tetuante/solarNodeCasting/README.md

# solarNodeCasting
Project to build a sensor node to be used for short-term solar casting
