tetuante/solarNodeCasting/PCB/presupuestos/Nodo solar/presupuesto.xlsx

Sheet: Total
Ref (PCB) | Qty | Type | Hand Soldering | Value | Footprint | Notes | Link | Price 1u (€) | Price 5u (€) | Price 10u (€) | Total Qty (5 nodes) | Total Qty (10 nodes) |  | Total 5n (€) | Total 10n (€)
C4 | 1 | THT | Y | 4700uF/10V | Capacitors_THT:CP_Radial_D13.0mm_P5.00mm | Electrolitico, paso 5 mm | https://www.digikey.es/product-detail/es/panasonic-electronic-components/EEU-FS1A472/P122372-ND/7381238 | 1.01000 | 1.01000 | 0.79800 | 5 | 10 |  | 5.05 | 7.98
C1 C2 C11 C12 | 4 | SMD | Y | 10uF/16V X5R | Capacitors_SMD:C_0805_HandSoldering |  | https://www.mouser.es/ProductDetail/KEMET/C0805C106K4PACTU/ | 0.24700 | 0.24700 | 0.11500 | 20 | 40 |  | 2.30 | 4.60
C3 | 1 | SMD | Y | 0.1uF | Capacitors_SMD:C_0805_HandSoldering |  | https://www.mouser.es/ProductDetail/KEMET/C0805C104K4RAC/ | 0.08500 | 0.08500 | 0.03700 | 5 | 10 |  | 0.43 | 0.37
C6 | 1 | SMD | Y | 10pF | Capacitors_SMD:C_0805_HandSoldering |  | https://www.mouser.es/ProductDetail/KEMET/C0805C100M4GACTU/ | 0.08500 | 0.08500 | 0.05400 | 5 | 10 |  | 0.43 | 0.54
C7 | 1 | SMD | Y | 1uF/10V X5R | Capacitors_SMD:C_0805_HandSoldering |  | https://www.mouser.es/ProductDetail/KEMET/C0805C105K8RACTM/ | 0.11100 | 0.11100 | 0.04600 | 5 | 10 |  | 0.56 | 0.46
C8 C9 C10 | 3 | SMD | Y | 22uF/10V X5R | Capacitors_SMD:C_0805_HandSoldering |  | https://www.mouser.es/ProductDetail/KEMET/C0805C226M8PACTU/ | 0.34900 | 0.34900 | 0.18400 | 15 | 30 |  | 2.76 | 5.52
C5 | 1 | SMD | Y | 10uF/10V | Capacitors_SMD:C_0805_HandSoldering |  | https://www.mouser.es/ProductDetail/KEMET/C0805C106K8PACTU/?qs=sGAEpiMZZMs0AnBnWHyRQI9zuYIiQALCxT7NLyqb6iU%3d | 0.20400 | 0.20400 | 0.13400 | 5 | 10 |  | 1.02 | 1.34
D1 | 1 | SMD | N | MBR120VLSFT1G | SolarNodeFootprints:D_SOD-123FL | Diodo rectificador | https://www.mouser.es/ProductDetail/ON-Semiconductor/MBR120VLSFT3G/ | 0.31500 | 0.31500 | 0.23800 | 5 | 10 |  | 1.57 | 2.38
D2 | 1 | SMD | Y | ORANGE | LEDs:LED_0805_HandSoldering | LED naranja Vf = 1.922 V If = 4 mA | https://www.mouser.es/ProductDetail/Kingbright/APTD2012LSYCK/ | 0.28100 | 0.28100 | 0.17400 | 5 | 10 |  | 1.41 | 1.74
D3 D5 | 2 | SMD | Y | GREEN | LEDs:LED_0805_HandSoldering | LED verde Vf = 1.946 If = 4 mA | https://www.mouser.es/ProductDetail/Kingbright/APTD2012LCGCK/ | 0.30600 | 0.30600 | 0.19000 | 10 | 20 |  | 1.90 | 3.80
D4 | 1 | SMD | Y | RED | LEDs:LED_0805_HandSoldering | LED rojo Vf = 1.858 If = 4 mA | https://www.mouser.es/ProductDetail/Kingbright/APTD2012LSURCK/ | 0.28100 | 0.28100 | 0.17400 | 5 | 10 |  | 1.41 | 1.74
J2 | 1 | THT | Y | microUSB CHRG | Connectors:USB_Micro-B | microUSB tipo B | https://www.mouser.es/ProductDetail/Hirose-Connector/ZX62D-B-5PA830/ | 0.59500 | 0.59500 | 0.47600 | 5 | 10 |  | 2.97 | 4.76
J1 | 1 | THT | Y | DCIN | Connectors:BARREL_JACK | 5.5 - 2.1 mm DC jack M | https://www.tme.eu/es/details/fc68148/conectores-dc/cliff/dc-10a-fc68148/ | 0.52000 | 0.52000 | 0.52000 | 5 | 10 |  | 2.60 | 5.20
J1 | 1 | EXT |  | DCIN | Connectors:BARREL_JACK | 5.5 - 2.1 mm DC jack F | https://www.tme.eu/es/details/pc-2.1_5.5-14/conectores-dc/ | 0.25400 | 0.25400 | 0.25400 | 5 | 10 |  | 1.27 | 2.54
J7 SC1 | 2 | SMD | N | BATT Solar_Cell | Connectors_JST:JST_PH_S2B-PH-SM4-TB_02x2.00mm_Angled | Conectores JST PH macho 2 pines | https://www.tme.eu/es/details/s2b-ph-sm4-tb/conectores-de-senal-raster-200mm/jst/ | 0.03380 | 0.03380 | 0.03380 | 10 | 20 |  | 0.34 | 0.68
 | 2 | EXT |  |  |  | Conectores JST PH hembra 2 pines | https://www.tme.eu/es/details/02kr-6h-p/conectores-de-senal-raster-200mm/jst/ | 0.30000 | 0.30000 | 0.30000 | 10 | 20 |  | 3.00 | 6.00
J3 J4 J5 J6 J8 | 1 | THT | Y |  | Pin headers. Male, 1x25 |  | https://www.mouser.es/ProductDetail/Molex/22-28-4250/ | 0.72300 | 0.72300 | 0.57000 | 5 | 10 |  | 3.61 | 5.70
 | 2 | EXT |  | DHT22 & DS18B20 | Pines hembra 3x1 | Conectores hembra | https://www.mouser.es/ProductDetail/Molex/14-60-0036/ | 0.67200 | 0.67200 | 0.58100 | 10 | 20 |  | 5.81 | 11.62
L1 | 1 | SMD | Y | NRS5030T1R0NMGJ | Inductors_SMD:L_Taiyo-Yuden_NR-50xx_HandSoldering | Inductor buck/boost | https://www.mouser.es/ProductDetail/Taiyo-Yuden/NRS5030T1R0NMGJ/ | 0.32300 | 0.32300 | 0.25200 | 5 | 10 |  | 1.61 | 2.52
Q1 | 1 | SMD | N | BSS138 | TO_SOT_Packages_SMD:SOT-23 | Transistor | https://www.mouser.es/ProductDetail/ON-Semiconductor-Fairchild/BSS138L/ | 0.18700 | 0.18700 | 0.12300 | 5 | 10 |  | 0.94 | 1.23
R15 | 1 | SMD | Y | 1153 | Resistors_SMD:R_0805_HandSoldering | 115k 1% | https://www.mouser.es/ProductDetail/Yageo/RC0805FR-07115KL/?qs=sGAEpiMZZMtlubZbdhIBIHuAoAkAo22N7v2fnh1eVEQ%3d | 0.08500 | 0.08500 | 0.01400 | 5 | 10 |  | 0.43 | 0.14
R16 | 1 | SMD | Y | 5602 | Resistors_SMD:R_0805_HandSoldering | 56k 1% | https://www.mouser.es/ProductDetail/Yageo/RC0805FR-0756KL/ | 0.08500 | 0.08500 | 0.01400 | 5 | 10 |  | 0.43 | 0.14
R3 R6 R9 R14 R13 | 5 | SMD | Y | 1001 | Resistors_SMD:R_0805_HandSoldering | 1k 1% | https://www.mouser.es/ProductDetail/Yageo/RC0805FR-071KL/?qs=sGAEpiMZZMtlubZbdhIBINUJ4p5cMnF1Rv8sEVwr4ss%3d | 0.08500 | 0.08500 | 0.01400 | 25 | 50 |  | 0.35 | 0.70
R1 | 1 | SMD | Y | 0 | Resistors_SMD:R_0805_HandSoldering | 0R 5% | https://www.mouser.es/ProductDetail/Yageo/RC0805JR-070RS/ | 0.11900 | 0.11900 | 0.01400 | 5 | 10 |  | 0.59 | 0.14
R10 | 1 | SMD | Y | 2703 | Resistors_SMD:R_0805_HandSoldering | 270k 1% | https://www.mouser.es/ProductDetail/Yageo/RC0805FR-07270KL/ | 0.08500 | 0.08500 | 0.01400 | 5 | 10 |  | 0.43 | 0.14
R11 R12 | 2 | SMD | Y | 104 | Resistors_SMD:R_0805_HandSoldering | 100k 5% | https://www.mouser.es/ProductDetail/Yageo/RC0805JR-07100KL/ | 0.08500 | 0.08500 | 0.01100 | 10 | 20 |  | 0.11 | 0.22
R7 R2 R5 | 3 | SMD | Y | 1053 | Resistors_SMD:R_0805_HandSoldering | 105k 1% | https://www.mouser.es/ProductDetail/Yageo/RC0805FR-07105KL/ | 0.08500 | 0.08500 | 0.01400 | 15 | 30 |  | 0.21 | 0.42
R4 R8 | 2 | SMD | Y | 105 | Resistors_SMD:R_0805_HandSoldering | 1M 5% | https://www.mouser.es/ProductDetail/Yageo/RC0805JR-071ML/ | 0.08500 | 0.08500 | 0.01100 | 10 | 20 |  | 0.11 | 0.22
RT1 | 1 | SMD | Y | 1503 | Resistors_SMD:R_0805_HandSoldering | 150k 1% | https://www.mouser.es/ProductDetail/Yageo/RC0805FR-07150KL/?qs=sGAEpiMZZMtlubZbdhIBIBEZimkhVqQ4txl6Q1oOo2U%3d | 0.08500 | 0.08500 | 0.01400 | 5 | 10 |  | 0.43 | 0.14
PROG | 1 | SMD | Y | 2001 | SolarNodeFootprints:R_0805_SMD_THT_HandSoldering | 2k 1% | https://www.mouser.es/ProductDetail/Yageo/RC0805FR-072KL/?qs=sGAEpiMZZMtlubZbdhIBIJv49G1poxg9G2UwItFTLLs%3d | 0.08500 | 0.08500 | 0.01400 | 5 | 10 |  | 0.43 | 0.14
THERM | 1 | EXT |  | 3950 NTC | SolarNodeFootprints:R_0805_SMD_THT_HandSoldering | 10k NTC B25/50 = 3950 +- 1% | https://www.mouser.es/ProductDetail/Murata/NXFT15XV103FA2B150/?qs=MY6wChARw2z2TBhtd5BylA%3d%3d | 0.85000 | 0.85000 | 0.56400 | 5 | 10 |  | 4.25 | 5.64
U3 | 2 | THT | Y | LoPy socket | SolarNodeFootprints:LoPy | 14x2 pines hembra largos | https://www.digikey.es/product-detail/es/samtec-inc/SSQ-114-03-T-S/SAM1206-14-ND/1111944 | 1.78000 | 1.78000 | 1.59300 | 10 | 20 |  | 15.93 | 31.86
U3 | 2 | THT | Y | LoPy socket | SolarNodeFootprints:LoPy | 14x2 pines hembra | https://www.digikey.es/product-detail/es/samtec-inc/SSQ-114-01-T-S/SAM1184-14-ND/1110803 | 1.63000 | 1.63000 | 1.45400 | 10 | 20 |  | 14.54 | 29.08
U4 | 1 | SMD | N | LMR982 | Housings_SSOP:MSOP-10_3x3mm_Pitch0.5mm | OpAmp LMR982FVM | https://www.mouser.es/ProductDetail/ROHM-Semiconductor/LMR982FVM-TR/ | 0.67200 | 0.67200 | 0.55700 | 5 | 10 |  | 3.36 | 5.57
U2 | 1 | SMD | N | MCP73871 | SolarNodeFootprints:QFN-20-1EP_4x4mm_Pitch0.5mm | Battery charger | https://www.mouser.es/ProductDetail/Microchip-Technology/MCP73871-2CCI-ML/ | 1.65000 | 1.65000 | 1.52000 | 5 | 10 |  | 8.25 | 15.20
U1 | 1 | SMD | N | TPS63060 | SolarNodeFootprints:S-PWSON-N10 | Power switch | https://www.mouser.es/ProductDetail/Texas-Instruments/TPS63060DSCR/ | 2.03000 | 2.03000 | 1.83000 | 5 | 10 |  | 10.15 | 18.30
 | 1 | EXT |  | LoPy |  | Microcontroller | https://www.mouser.es/ProductDetail/Pycom/LoPy/ | 25.710 | 25.710 | 25.710 | 5 | 10 |  | 128.55 | 257.10
 | 1 | EXT |  | Expansion board |  | Pycom Expansion board | https://www.mouser.es/ProductDetail/Pycom/Expansion-Board/ | 14.720 | 14.720 | 14.720 | 5 | 10 |  | 73.60 | 147.20
 | 1 | EXT |  | Antena LoRa |  | 868 MHz | https://www.mouser.es/ProductDetail/Pycom/LoRa-Sigfox-Antenna-Kit/ | 8.280 | 8.280 | 8.280 | 5 | 10 |  | 41.40 | 82.80
 | 1 | EXT |  | DHT22 |  | T&RH sensor | https://www.mouser.es/ProductDetail/Adafruit/393/?qs=sGAEpiMZZMsMyYRRhGMFNjQer5SXmdKhqdCeGzcwTcI%3d | 12.75000 | 12.75000 | 12.75000 | 5 | 10 |  | 63.75 | 127.50
 | 1 | EXT |  | DS18B20 |  | T sensor | https://www.mouser.es/ProductDetail/Maxim-Integrated/DS18B20+/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 | 2.36000 | 2.36000 | 2.33000 | 5 | 10 |  | 11.80 | 23.30
 | 1 | EXT |  |  |  | Batería LiPo 800 mAh | https://www.tme.eu/es/details/accu-lp503448_cl/baterias/cellevia-batteries/l503448/ | 5.83000 | 5.25000 | 5.25000 | 5 | 10 |  | 26.25 | 52.50
 | 1 | EXT |  |  |  | Panel solar medida | https://www.digikey.es/product-detail/es/ixys/KXOB22-12X1F/KXOB22-12X1F-ND/4840079 | 1.82000 | 1.82000 | 1.64400 | 5 | 10 |  | 9.10 | 16.44
 | 1 | EXT |  |  |  | Panel solar alimentación 6V | https://www.mouser.es/ProductDetail/Adafruit/200/ | 25.64000 | 25.64000 | 25.64000 | 5 | 10 |  | 128.20 | 256.40
Total: | 41 | SMD |  |  |  |  |  |  |  |  |  |  | Total (€): | 583.61 | 1142.01
Total: | 8 | THT
Total: | 14 | EXT |  |  |  |  |  |  |  |  |  |  | Envío TME (€): | 7.90
 |  |  |  |  |  |  |  |  |  |  |  |  | Digikey (€): | 44.62 | 85.36
 |  |  |  |  |  |  |  |  |  |  |  |  | Mouser (€): | 505.53 | 989.73
 |  |  |  |  |  |  |  |  |  |  |  |  | TME (€): | 33.46 | 66.92
 |  |  |  |  |  |  |  |  |  |  |  |  | Digikey THT (€): | 35.52 | 68.92
 |  |  |  |  |  |  |  |  |  |  |  |  | Mouser THT (€): | 6.59 | 10.46
 |  |  |  |  |  |  |  |  |  |  |  |  | TME THT (€): | 2.60 | 5.20
 |  |  |  |  |  |  |  |  |  |  |  |  | Digikey SMD (€): | 0.00 | 0.00
 |  |  |  |  |  |  |  |  |  |  |  |  | Mouser SMD (€): | 41.58 | 67.71
 |  |  |  |  |  |  |  |  |  |  |  |  | TME SMD (€): | 0.34 | 0.68
 |  |  |  |  |  |  |  |  |  |  |  |  | Digikey EXT (€): | 9.10 | 16.44
 |  |  |  |  |  |  |  |  |  |  |  |  | Mouser EXT (€): | 457.36 | 911.56
 |  |  |  |  |  |  |  |  |  |  |  |  | TME EXT (€): | 30.52 | 61.04

Sheet: Digikey
Comprado | Ref (PCB) | Qty | Type | Hand Soldering | Value | Footprint | Notes | Link | Price 1u (€) | Price 5u (€) | Price 10u (€) | Total Qty (5 nodes) | Total Qty (10 nodes) | Total 5n (€) | Total 10n (€)
SI | C4 | 1 | THT | Y | 4700uF/10V | Capacitors_THT:CP_Radial_D13.0mm_P5.00mm | Electrolitico, paso 5 mm | https://www.digikey.es/product-detail/es/panasonic-electronic-components/EEU-FS1A472/P122372-ND/7381238 | 1.01000 | 1.01000 | 0.79800 | 5 | 10 | 5.05 | 7.98
SI | U3 | 2 | THT | Y | LoPy socket | SolarNodeFootprints:LoPy | 14x2 pines hembra largos | https://www.digikey.es/product-detail/es/samtec-inc/SSQ-114-03-T-S/SAM1206-14-ND/1111944 | 1.78000 | 1.78000 | 1.59300 | 10 | 20 | 15.93 | 31.86
SI | U3 | 2 | THT | Y | LoPy socket | SolarNodeFootprints:LoPy | 14x2 pines hembra | https://www.digikey.es/product-detail/es/samtec-inc/SSQ-114-01-T-S/SAM1184-14-ND/1110803 | 1.63000 | 1.63000 | 1.45400 | 10 | 20 | 14.54 | 29.08
SI | SC1 | 1 | EXT |  |  |  | Panel solar medida | https://www.digikey.es/product-detail/es/ixys/SLMD121H04L/SLMD121H04L-ND/3463124 | 5.19000 | 5.19000 | 4.66700 | 5 | 10 | 25.95 | 46.67
AGOTADO | SC1 | 1 | EXT |  |  |  | Panel solar medida | https://www.digikey.es/product-detail/es/ixys/KXOB22-12X1F/KXOB22-12X1F-ND/4840079 | 1.82000 | 1.82000 | 1.64400 | 5 | 10 | 9.10 | 16.44

Sheet: Mouser
Comprado | Ref (PCB) | Qty | Type | Hand Soldering | Value | Footprint | Notes | Link | Price 1u (€) | Price 5u (€) | Price 10u (€) | Total Qty (5 nodes) | Total Qty (10 nodes) | Total 5n (€) | Total 10n (€)
SI | J2 | 1 | THT | Y | microUSB CHRG | Connectors:USB_Micro-B | microUSB tipo B | https://www.mouser.es/ProductDetail/Hirose-Connector/ZX62D-B-5PA830/ | 0.59500 | 0.59500 | 0.47600 | 5 | 10 | 2.97 | 4.76
SI | J3 J4 J5 J6 J8 | 1 | THT | Y |  | Pin headers. Male, 1x25 |  | https://www.mouser.es/ProductDetail/Molex/22-28-4250/ | 0.72300 | 0.72300 | 0.57000 | 5 | 10 | 3.61 | 5.70
SI | J5 J6 | 2 | EXT |  | DHT22 & DS18B20 | Pines hembra 3x1 | Conectores hembra | https://www.mouser.es/ProductDetail/Molex/14-60-0036/ | 0.67200 | 0.67200 | 0.58100 | 10 | 20 | 5.81 | 11.62
SI | THERM | 1 | EXT |  | 3950 NTC | SolarNodeFootprints:R_0805_SMD_THT_HandSoldering | 10k NTC B25/50 = 3950 +- 1% | https://www.mouser.es/ProductDetail/Murata/NXFT15XV103FA2B150/?qs=MY6wChARw2z2TBhtd5BylA%3d%3d | 0.85000 | 0.85000 | 0.56400 | 5 | 10 | 4.25 | 5.64
SI | U3 | 1 | EXT |  | LoPy |  | Microcontroller | https://www.mouser.es/ProductDetail/Pycom/LoPy/ | 25.710 | 25.710 | 25.710 | 5 | 10 | 128.55 | 257.10
SI |  | 1 | EXT |  | Expansion board |  | Pycom Expansion board | https://www.mouser.es/ProductDetail/Pycom/Expansion-Board/ | 14.720 | 14.720 | 14.720 | 5 | 10 | 73.60 | 147.20
SI |  | 1 | EXT |  | Antena LoRa |  | 868 MHz | https://www.mouser.es/ProductDetail/Pycom/LoRa-Sigfox-Antenna-Kit/ | 8.280 | 8.280 | 8.280 | 5 | 10 | 41.40 | 82.80
SI | J6 | 1 | EXT |  | DHT22 |  | T&RH sensor | https://www.mouser.es/ProductDetail/Adafruit/393/?qs=sGAEpiMZZMsMyYRRhGMFNjQer5SXmdKhqdCeGzcwTcI%3d | 12.75000 | 12.75000 | 12.75000 | 5 | 10 | 63.75 | 127.50
SI | J5 | 1 | EXT |  | DS18B20 |  | T sensor | https://www.mouser.es/ProductDetail/Maxim-Integrated/DS18B20+/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 | 2.36000 | 2.36000 | 2.33000 | 5 | 10 | 11.80 | 23.30
SI | J1 | 1 | EXT |  |  |  | Panel solar alimentación 6V | https://www.mouser.es/ProductDetail/Adafruit/200/ | 25.64000 | 25.64000 | 25.64000 | 5 | 10 | 128.20 | 256.40

Sheet: TME
Comprado | Ref (PCB) | Qty | Type | Hand Soldering | Value | Footprint | Notes | Link | Price 1u (€) | Price 5u (€) | Price 10u (€) | Total Qty (5 nodes) | Total Qty (10 nodes) | Total 5n (€) | Total 10n (€)
NO | J1 | 1 | THT | Y | DCIN | Connectors:BARREL_JACK | 5.5 - 2.1 mm DC jack M | https://www.tme.eu/es/details/fc68148/conectores-dc/cliff/dc-10a-fc68148/ | 0.52000 | 0.52000 | 0.52000 | 5 | 10 | 2.60 | 5.20
NO | J1 | 1 | EXT |  | DCIN | Connectors:BARREL_JACK | 5.5 - 2.1 mm DC jack F | https://www.tme.eu/es/details/pc-2.1_5.5-14/conectores-dc/ | 0.25400 | 0.25400 | 0.25400 | 5 | 10 | 1.27 | 2.54
NO | J7 SC1 | 2 | EXT |  |  |  | Conectores JST PH hembra 2 pines | https://www.tme.eu/es/details/02kr-6h-p/conectores-de-senal-raster-200mm/jst/ | 0.30000 | 0.30000 | 0.30000 | 10 | 20 | 3.00 | 6.00
NO | J7 | 1 | EXT |  |  |  | Batería LiPo 800 mAh | https://www.tme.eu/es/details/accu-lp503448_cl/baterias/cellevia-batteries/l503448/ | 5.83000 | 5.25000 | 5.25000 | 5 | 10 | 26.25 | 52.50
