tetuante/solarNodeCasting/PCB/presupuestos/Piranometros/presupuesto.xlsx

Comprado | Ref (PCB) | Qty/board | Type | Value | Notes | Link | Price 1u (€) | Price 5u (€) | Price 10u (€) | Price/board (€) | Price/5boards (€) | Price/10boards (€) | Total/board (€) | Total/5boards (€) | Total/10boards (€)
NO |  | 1 | THT | YR1B100RCC | 100R 0.1% | https://www.mouser.es/ProductDetail/TE-Connectivity/YR1B100RCC/ | 0.32700 | 0.32700 | 0.32700 | 0.32700 | 1.63500 | 3.27000 | 7.004 | 35.02 | 62.74
NO | U2 | 1 | SMD | AD8237ARMZ-R7 | In-Amp | https://www.mouser.es/productdetail/analog-devices/ad8237armz-r7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 | 2.17000 | 2.17000 | 1.94000 | 2.17000 | 10.85000 | 19.40000
NO | U1 | 1 | SMD | AD8538AUJZ-REEL7 | Op-Amp | https://www.mouser.es/ProductDetail/Analog-Devices-Inc/AD8538AUJZ-REEL7/ | 1.19000 | 1.19000 | 1.07000 | 1.19000 | 5.95000 | 10.70000
NO | U3 | 1 | SMD | NTGD1100LT1G | Power MOSFET | https://www.mouser.es/ProductDetail/ON-Semiconductor/NTGD1100LT1G/ | 0.50200 | 0.50200 | 0.41500 | 0.50200 | 2.51000 | 4.15000
NO | R3 | 1 | SMD | PCF0805R-1K0BI | 1K 0.1% | https://www.mouser.es/ProductDetail/TT-Electronics/PCF0805R-1K0BI/ | 0.15300 | 0.15300 | 0.15300 | 0.15300 | 0.76500 | 1.53000
NO | R5 | 1 | SMD | PCF0805R-200KBI | 200K 0.1% | https://www.mouser.es/ProductDetail/TT-Electronics/PCF0805R-200KBI/ | 0.15300 | 0.15300 | 0.15300 | 0.15300 | 0.76500 | 1.53000
NO | SW2 SW3 | 2 | THT | 0S103011MS8QP1 | SP3T switch | https://www.mouser.es/ProductDetail/CK-Components/0S103011MS8QP1/ | 0.43400 | 0.43400 | 0.43400 | 0.86800 | 4.34000 | 8.68000
NO | SW1 | 1 | THT | 0S102011MS2QN1 | SPDT switch | https://www.mouser.es/ProductDetail/CK-Components/0S102011MS2QN1/ | 0.33200 | 0.33200 | 0.33200 | 0.33200 | 1.66000 | 3.32000
NO | C1 | 1 | SMD | C0805C104K4RAC | 0.1uF 16V 10% | https://www.mouser.es/ProductDetail/KEMET/C0805C104K4RAC/ | 0.08500 | 0.08500 | 0.03700 | 0.08500 | 0.42500 | 0.37000
NO | J2 | 1 | THT | EM366503 | Terminal block | https://www.mouser.es/ProductDetail/Eaton/EM366503/ | 0.32300 | 0.32300 | 0.31900 | 0.32300 | 1.61500 | 3.19000
NO | J1 | 1 | THT | M20-7820546 | Female pins | https://www.mouser.es/productdetail/harwin/m20-7820546 | 0.73100 | 0.73100 | 0.58800 | 0.73100 | 3.65500 | 5.88000
NO | R4 R6 | 2 | SMD | CRCW0805100KJNEA | 100K 5% | https://www.mouser.es/productdetail/vishay/crcw0805100kjnea?qs=sGAEpiMZZMvdGkrng054txEw7b1YnvGuWk57hmbzOr0%3D | 0.08500 | 0.08500 | 0.03600 | 0.17000 | 0.85000 | 0.72000
