tetuante/solarNodeCasting/soporte/celula22x7/Soporte18x18x12.3mf

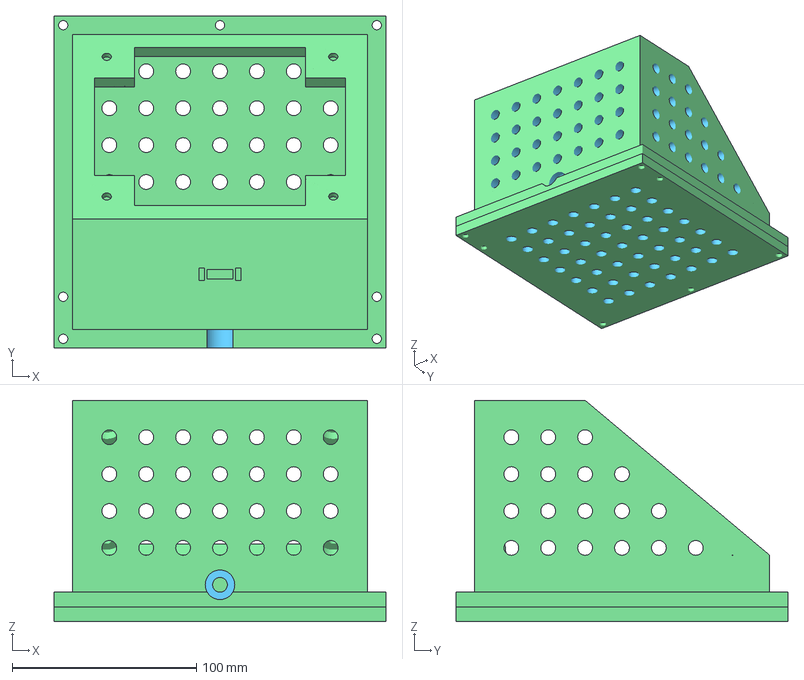
[picture p1: CAD file, 2018-02-06]
soporte/celula22x7/Soporte18x18x12.3mf
180.0 x 180.0 x 120.0 mm
