tetuante/solarNodeCasting/soporte/partes.3mf

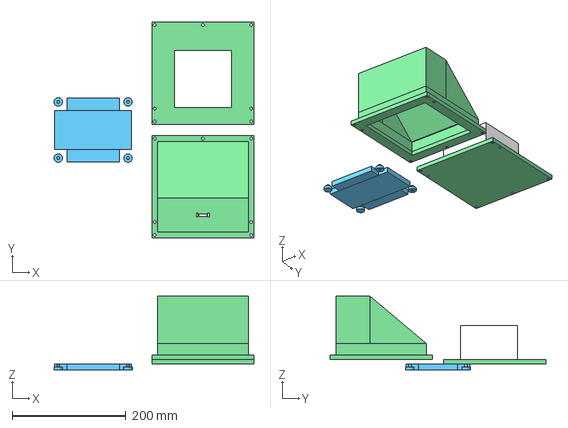
[picture p2: CAD file, 2018-02-06]
soporte/partes.3mf
352.2 x 380.0 x 130.0 mm
