tetuante/solarNodeCasting/soporte/celula22x7/Soporte18x18x10.3mf

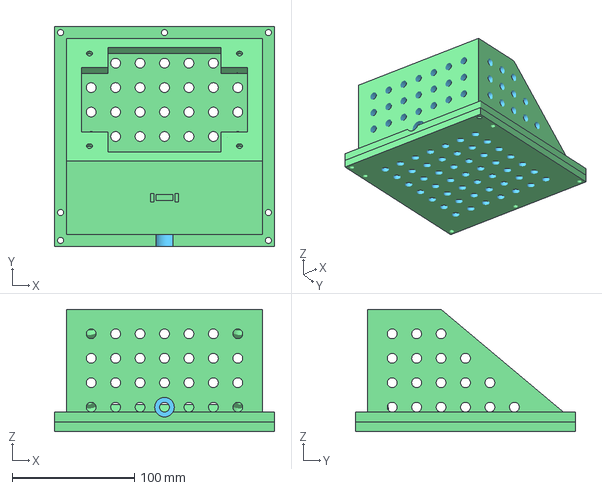
[picture p3: CAD file, 2018-02-06]
soporte/celula22x7/Soporte18x18x10.3mf
180.0 x 180.0 x 100.0 mm
