tetuante/solarNodeCasting/(list of files, cad)

Other CAD files:
soporte/celula43x14/Soporte18x18x12.3mf
soporte/celula43x14/Soporte18x18x10.3mf
