tetuante/solarNodeCasting/(threads)

Thread 1 (2019-01-16):

SolarNode ExpansionBoard - SD card problem

PiotrParysek, 2019-01-16:
In design and gerbers files of Expansion Board  [https://github.com/tetuante/solarNodeCasting/blob/master/PCB/PyraExtension.zip](url)
The pins have different programming (used shortcuts: lopy:L; original Espansion Board:EX; PyraExtension:PX)

- L: **P24** <-> EX: **G24** <-> PX:**SDA0**=P3 in the project is assigned to gather data from DS18X20. Originally this pin is assigned as sdDATA1
- L:**P21**  <-> EX:**G11**  <-> PX:**SDA1**=P4 is the project is assigned to gather data from AM2302. Originally this pin is assigned as sdCMD

Usage of this pins for gathering data  makes imposible for usage SD card
