tetuante/solarNodeCasting/LoPy/codigoLoRa/boot.py

# REPL duplication on UART0 for serial connection
from machine import UART
import os
uart = UART(0, 115200)
os.dupterm(uart)

# Disable heartbeat LED
from pycom import heartbeat
heartbeat(False)

# Disable WiFi radio
from network import WLAN
wlan = WLAN()
wlan.deinit()
