tetuante/solarNodeCasting/(commit log)

2018-01-19 Added LoPy scripts
    [20170718.csv, 20170719.csv, 20170720.csv, 20170721.csv, 20170725.csv, 20170727-28.csv, 20170801-02.csv, 20170804.csv]
2018-01-29 Print number of invalid files
2018-01-31 Added PCB designs (KiCAD)
2018-01-31 Added BOM files
    [presupuesto.xlsx]
2018-01-31 Minor changes
    [presupuesto.xlsx]
2018-02-06 Updated BOM
    [presupuesto.xlsx]
2018-02-06 Added 3D builder designs
    [Soporte18x18x10.3mf, Soporte18x18x12.3mf, partes.3mf]
2018-02-09 Added scripts to test the board
